74hc595/1-Bit-AVR-Synthesizer/circuit/synth-sm.png

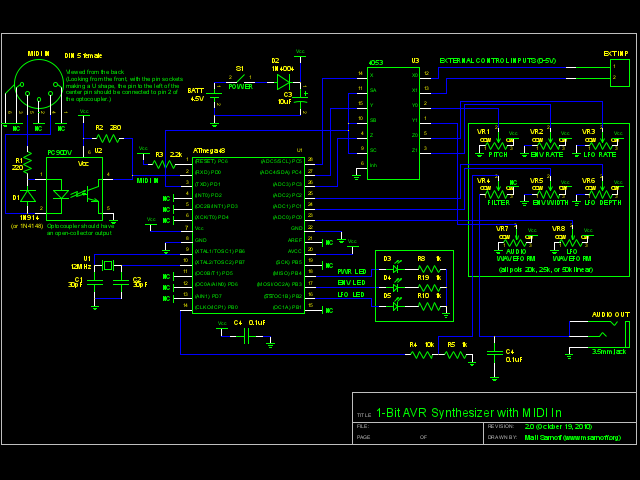
circuit/synth-sm.png
