74hc595/1-Bit-AVR-Synthesizer/circuit/synth.png

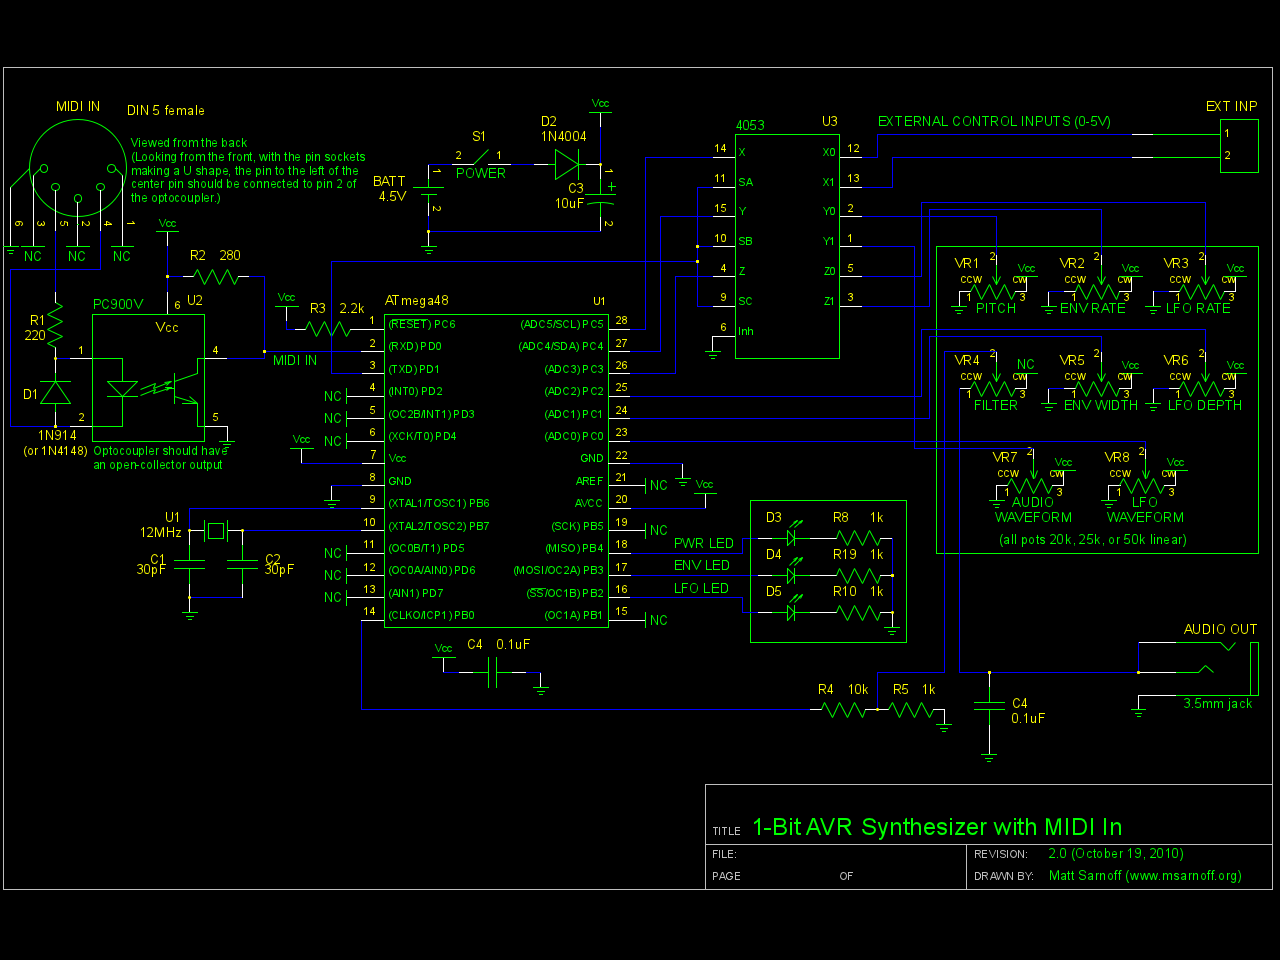
circuit/synth.png
