74hc595/1-Bit-AVR-Synthesizer/(commit log)

2010-10-24 changed knob locations, added front panel image
    [synth.sch]
2011-03-11 fixed LED pin labels in schematic; adding bitmaps
    [synth.sch]
2011-03-11 fixed circuit bitmaps
